ema-rauf/PulseToken/BOM.csv

Item | Qty | Supplier | Cost/item | Total Cost | link
Seeed XIAO ESP32-C3 | 1 | Local market (not listed on Colgroad) | $4.99 | $4.99 | https://www.seeedstudio.com/Seeed-XIAO-ESP32C3-p-5431.html
AS608 Fingerprint Reader Optical Sensor Module | 1 | Colgroad | $7.14 | $7.14 | https://colgroad.com/product/as608-fingerprint-reader-optical-sensor-module/
0.96" 128×64 I2C OLED (SSD1306) | 1 | Colgroad | $1.71 | $1.71 | https://colgroad.com/product/0-96-inch-128x64-i2c-oled-display-module/
DS3231 RTC module | 1 | Colgroad | $2.14 | $2.14 | https://colgroad.com/product/ds3231-rtc-real-time-clock-module/
Tactile push button 6×6×5 mm | 3 | Colgroad | $0.07 | $0.21 | https://colgroad.com/product/tactile-push-button-switch/
JST-PH 2.0 mm 2-pin male header | 1 | Colgroad | $0.02 | $0.02 | https://colgroad.com/product/jst-male-connector-2-0mm-2-pin-straight/
3.7 V 800 mAh LiPo (803035) | 1 | Colgroad | $1.07 | $1.07 | https://colgroad.com/product/3-7v-800mah-803035-2-96wh-lipo-rechargeable-battery/
10 kΩ resistor, 1/4 W | 1 | Colgroad | $0.02 | $0.02 | https://colgroad.com/product/metal-film-resistors-1k%cf%89-10m%cf%89-1-4-watt/
Jumper wires, 20 cm (pack) | 1 | Colgroad | $0.71 | $0.71 | https://colgroad.com/product/20cm-male-to-male-pin-to-pin-jumper-wires-set-20pcs-40pcs/
Estimated total shipping | 1 |  |  | $10.00
