ema-rauf/PulseToken/cad/pulsetoken_assembly.step

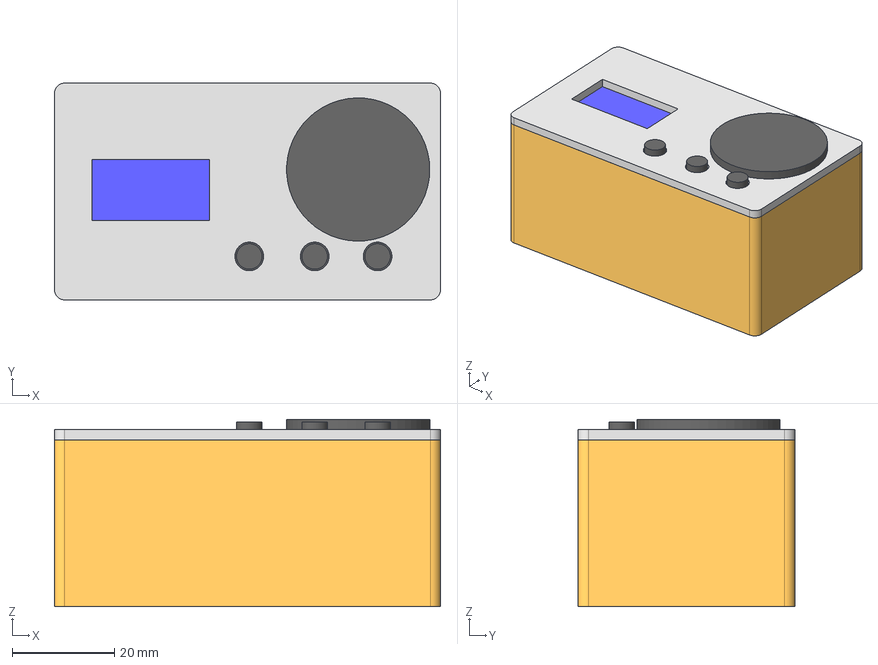
[picture p8: CAD file, 2026-10-18]
cad/pulsetoken_assembly.step
75.5 x 42.4 x 36.6 mm
board
bottom
lid
battery
xiao
fingerprint
oled
cap1
cap2
cap3
