ema-rauf/PulseToken/pcb/PulseToken/PulseToken.step

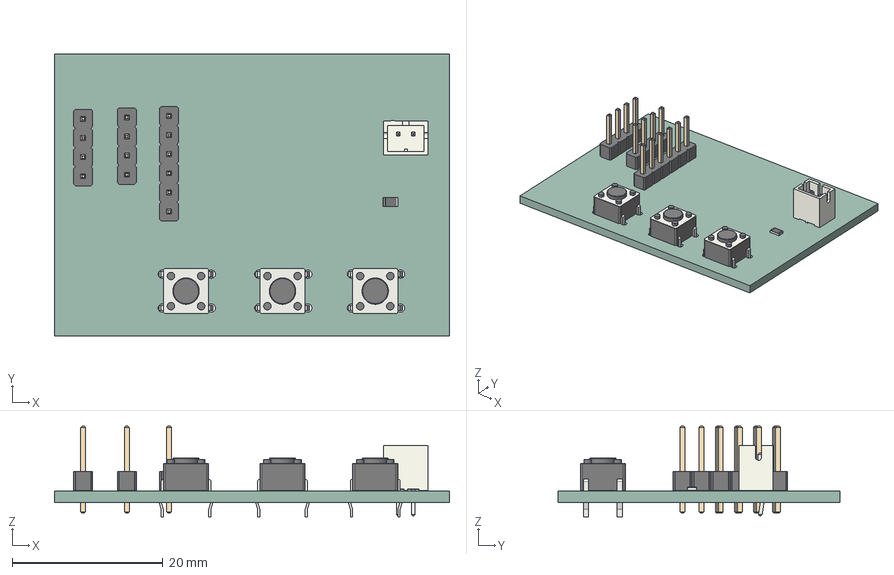
[picture p9: CAD file, 2026-10-18]
pcb/PulseToken/PulseToken.step
52.4 x 37.4 x 12.0 mm
R_0805_2012Metric
PinHeader_1x06_P254mm_Vertical
JST_B2B_PH_K
SW_PUSH_6mm x 3
PinHeader_1x04_P254mm_Vertical x 2
PulseToken-unsaved-export-3H4qLJ_PCB
