ema-rauf/PulseToken/cad/pulsetoken_lid.step

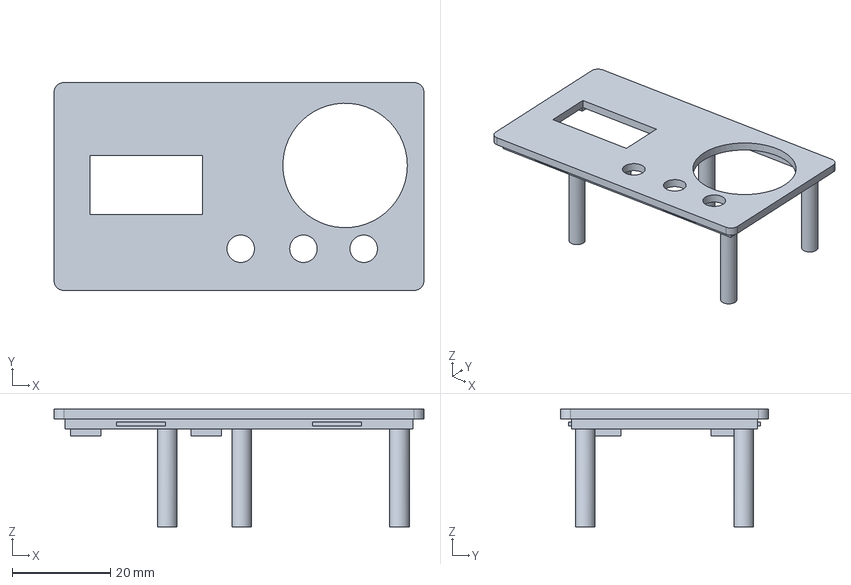
[picture p10: CAD file, 2026-10-18]
cad/pulsetoken_lid.step
75.5 x 42.4 x 24.0 mm
