ema-rauf/PulseToken/cad/pulsetoken_button_cap.step

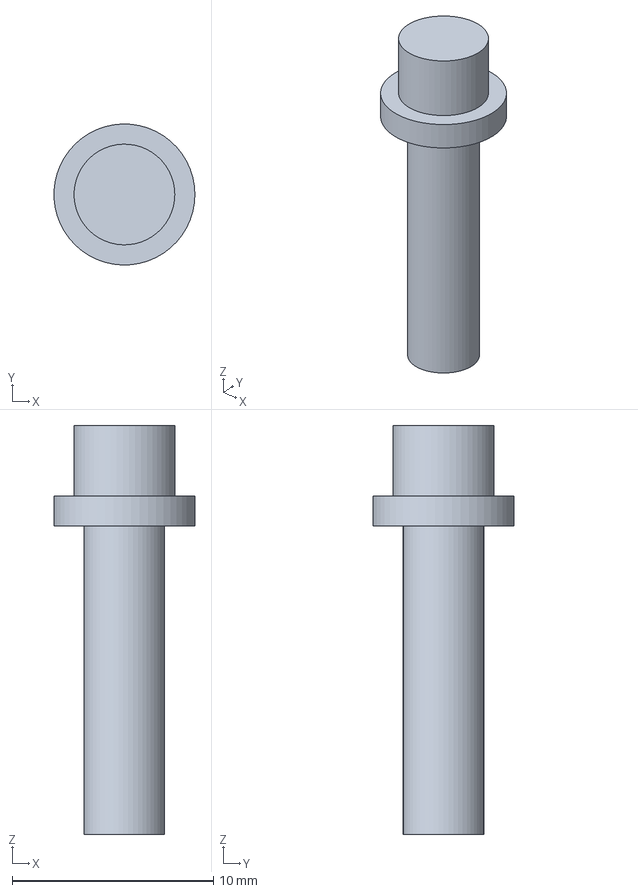
[picture p11: CAD file, 2026-10-18]
cad/pulsetoken_button_cap.step
6.99 x 7.00 x 20.3 mm
