ema-rauf/PulseToken/cad/pulsetoken_bottom.step

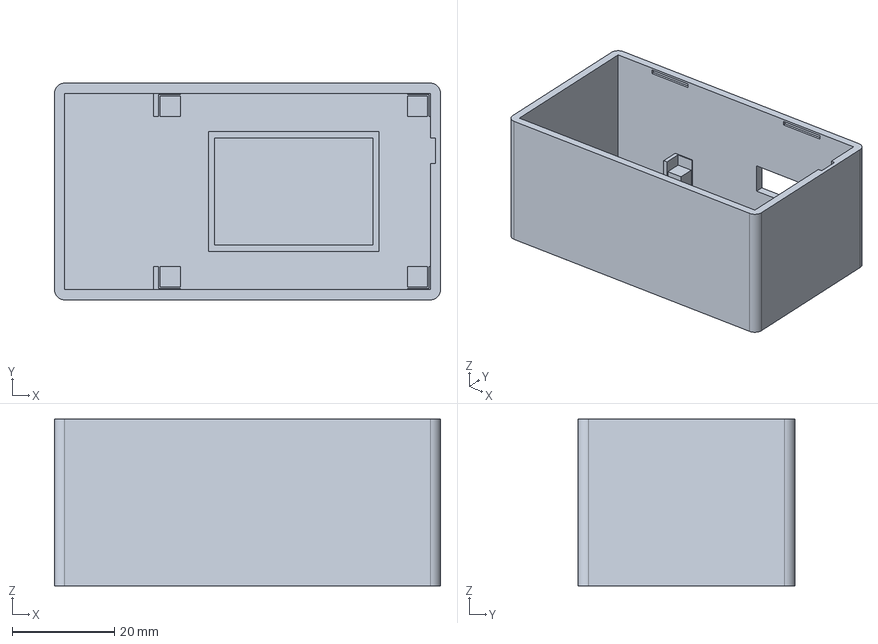
[picture p12: CAD file, 2026-10-18]
cad/pulsetoken_bottom.step
75.5 x 42.4 x 32.6 mm
