ema-rauf/PulseToken/(list of files, cad)

Other CAD files:
cad/pulsetoken_bottom.stl
cad/pulsetoken_button_cap.stl
cad/pulsetoken_lid.stl
