ema-rauf/PulseToken/pcb/PulseToken/PulseToken.kicad_pcb

## KiCad design pcb/PulseToken/PulseToken.kicad_pcb (2026-10-18)

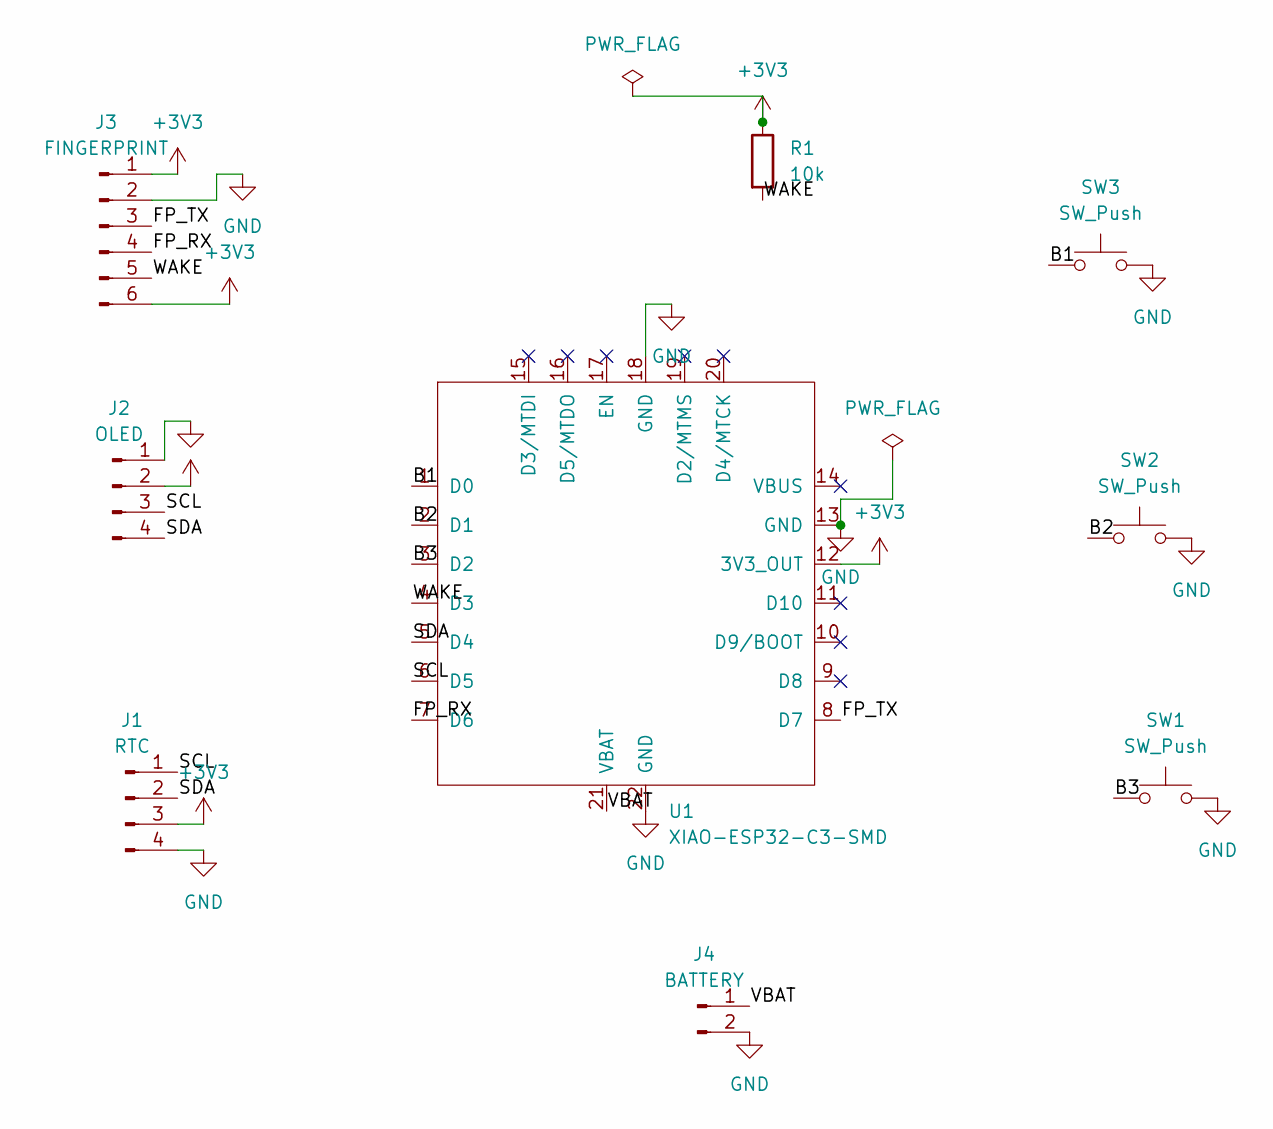
[picture p13: schematic PulseToken.kicad_sch]

Parts:
J1: RTC; PinHeader_1x04_P2.54mm_Vertical
J2: OLED; PinHeader_1x04_P2.54mm_Vertical
J3: FINGERPRINT; PinHeader_1x06_P2.54mm_Vertical
J4: BATTERY; JST_PH_B2B-PH-K_1x02_P2.00mm_Vertical
R1: 10k; R_0805_2012Metric_Pad1.20x1.40mm_HandSolder
SW1, SW2, SW3: SW_Push; SW_PUSH_6mm
U1: XIAO-ESP32-C3-SMD

Connections:
+3V3: J1.3, J2.2, J3.1, J3.6, R1.1, U1.12 (3V3_OUT)
/B1: SW3.1, U1.1 (D0)
/B2: SW2.1, U1.2 (D1)
/B3: SW1.1, U1.3 (D2)
/FP_RX: J3.4, U1.7 (D6)
/FP_TX: J3.3, U1.8 (D7)
/SCL: J1.1, J2.3, U1.6 (D5)
/SDA: J1.2, J2.4, U1.5 (D4)
/VBAT: J4.1, U1.21 (VBAT)
/WAKE: J3.5, R1.2, U1.4 (D3)
GND: J1.4, J2.1, J3.2, J4.2, SW1.2, SW2.2, SW3.2, U1.13 (GND), U1.18 (GND), U1.22 (GND)

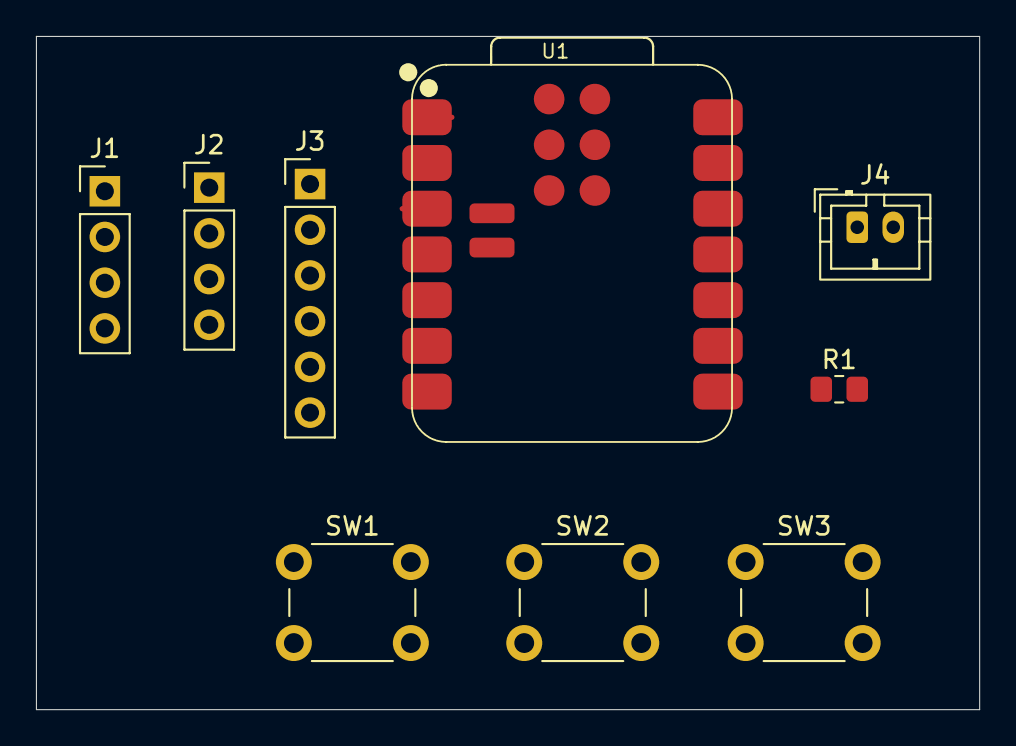
[picture p14: board PulseToken.kicad_pcb from above]

Board: 2 copper layers, 52.4 x 37.4 mm, 9 parts (0 on the bottom side), 11 nets.
