ema-rauf/PulseToken/(commit log)

2026-10-18 PulseToken: PCB, enclosure CAD, STL, README
    [PulseToken.kicad_pcb, PulseToken.kicad_sch, PulseToken.step, pulsetoken_assembly.step, pulsetoken_bottom.step, pulsetoken_bottom.stl, pulsetoken_button_cap.step, pulsetoken_button_cap.stl]
2026-10-18 Sync PulseToken from Half Life
    [BOM.csv]
